jimidenooyer/Parametric-LG-Stove-Knob-Replacement/(commit log)

2026-10-19 Enhance README with detailed usage and print settings
    Expanded the README to include detailed instructions, file descriptions, and crucial print settings for the parametric LG stove knob replacement.
2026-10-19 Add files via upload
    Note: these adjustments are for my project. Since I uploaded this for others trying to fabricate a part to fix my issue, I want the the code to apply to this fix.
    Adjusted the internal clearance variables to match physical measurements taken from the LG stove to ensure a perfect friction fit and prevent binding.
    Standoff Clearance: Measured the stove's physical plastic screw standoffs at 5.75mm. Increased screw_dia to 6.2mm so the 3D-printed holes slide over them smoothly without scraping or binding after ABS shrinkage.
    Faceplate Gap: Measured the recessed mounting plate cavity on the stove at roughly 5mm deep. Extended col_reach to 17.5mm to bridge this gap, e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
    [OvenKnobFix.scad]
